Timon14kraan/Project-Proces-and-Safety/src/SUMMARY.md

# Summary

- [Structure](Structure.md)
- [Choices_description](./Choices_description.md)
- [Connections](./Connections.md)
- [Riskassesment](./Riskassessment.md)
- [Flowchart](./Flowchart.md)
- [Materials](./Materials.md)
- [Tasks](./Tasks.md)
