Timon14kraan/Project-Proces-and-Safety/External Documents/Solidworks/Bovenkant motor.JPG

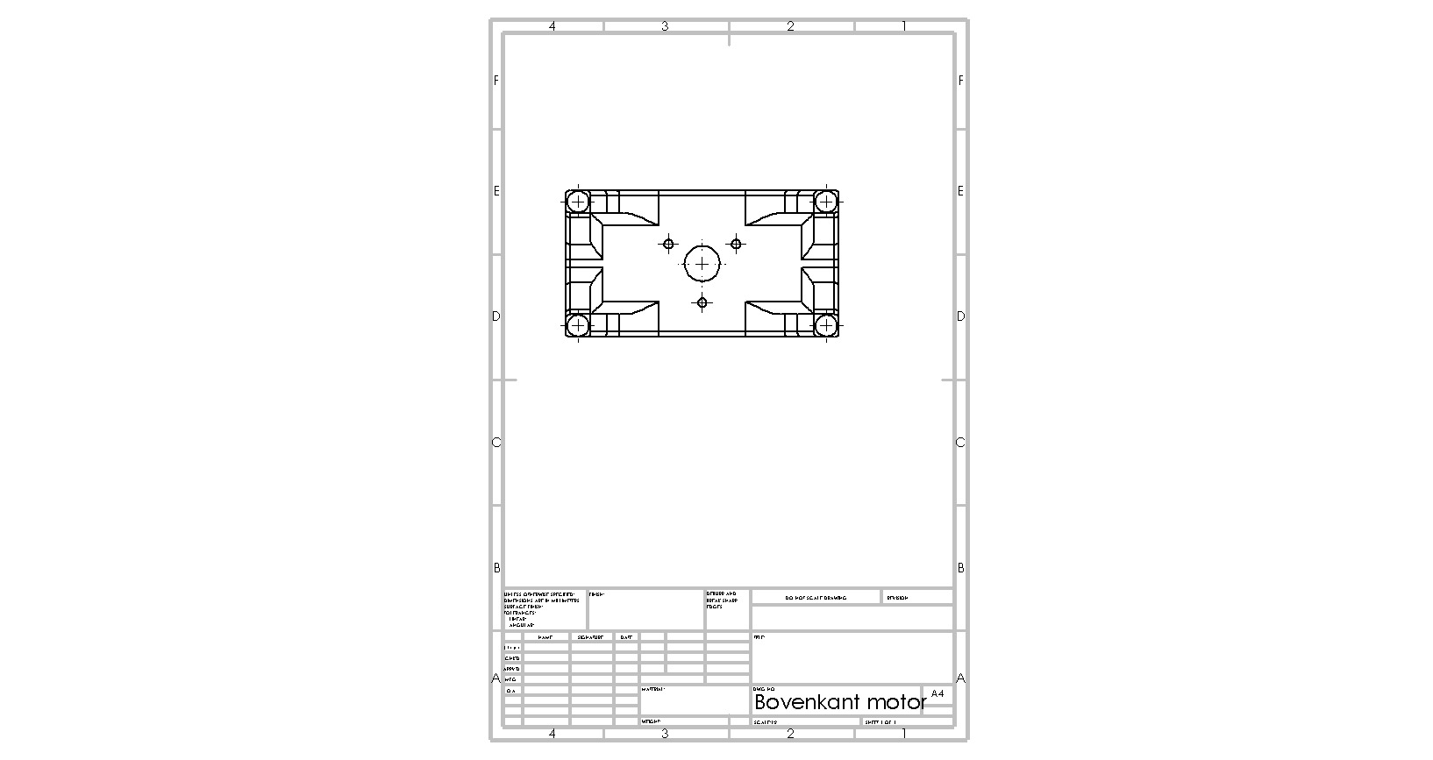
External Documents/Solidworks/Bovenkant motor.JPG
