Timon14kraan/Project-Proces-and-Safety/External Documents/Solidworks/motor_station_assembly.SLDASM

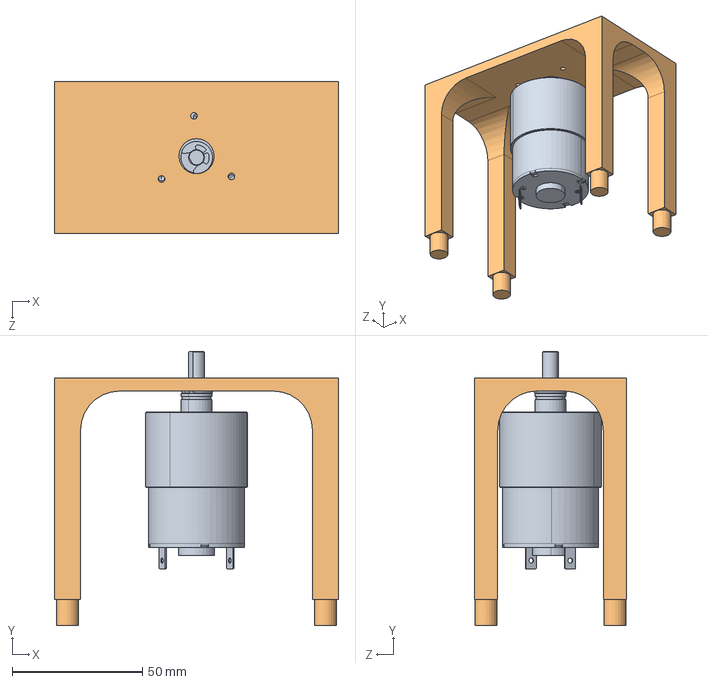
[picture p2: CAD file, 2024-01-18]
External Documents/Solidworks/motor_station_assembly.SLDASM
109.0 x 105.2 x 58.5 mm
Bovenkant motor
motor
