Timon14kraan/Project-Proces-and-Safety/External Documents/Solidworks/Gripper/MGP810N(01).sldasm

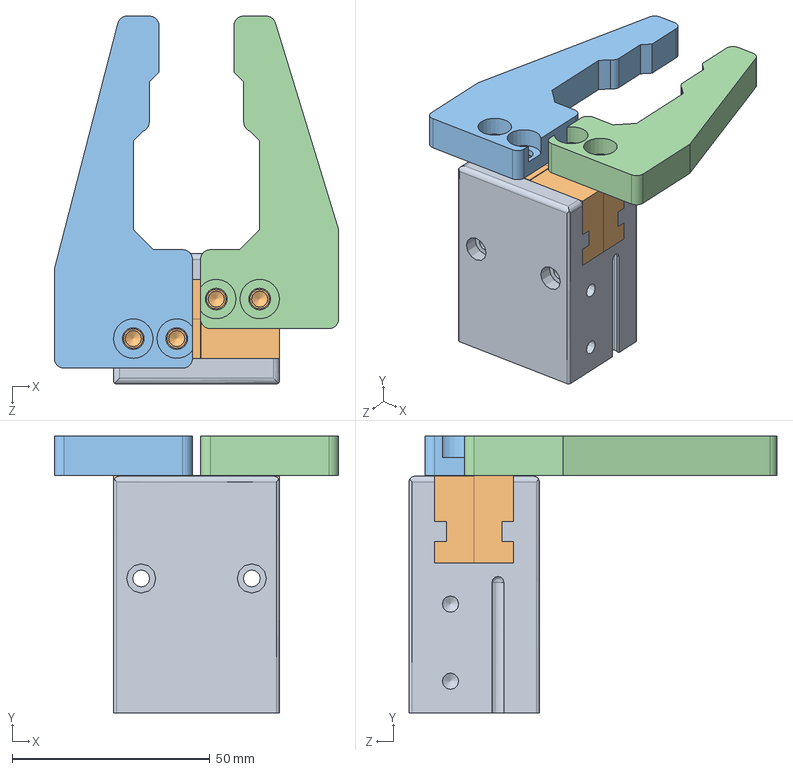
[picture p3: CAD file, 2024-01-18]
External Documents/Solidworks/Gripper/MGP810N(01).sldasm
72.0 x 70.0 x 93.1 mm
zylinder-MGP810N
bac-MGP810N1 x 2
gripper1_rev
gripper2_rev
