Timon14kraan/Project-Proces-and-Safety/External Documents/Solidworks/Bovenkant motor-DESKTOP-68PBQKE.SLDPRT

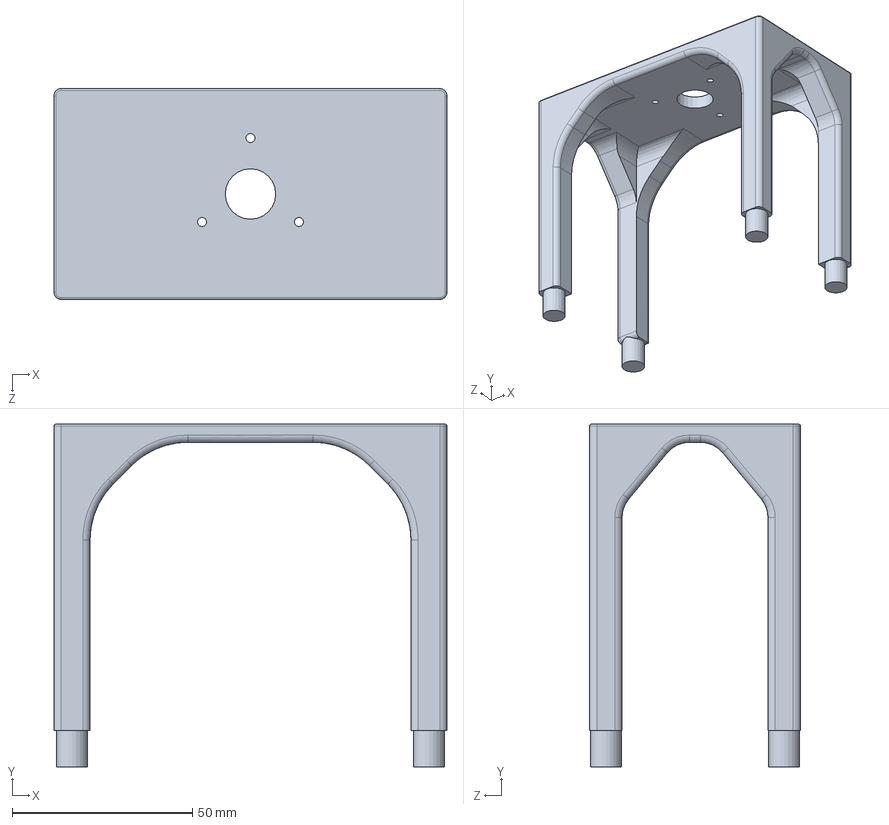
[picture p4: CAD file, 2024-01-18]
External Documents/Solidworks/Bovenkant motor-DESKTOP-68PBQKE.SLDPRT
109.0 x 95.0 x 58.5 mm
