Timon14kraan/Project-Proces-and-Safety/External Documents/Solidworks/Gripper/gripper2.SLDPRT

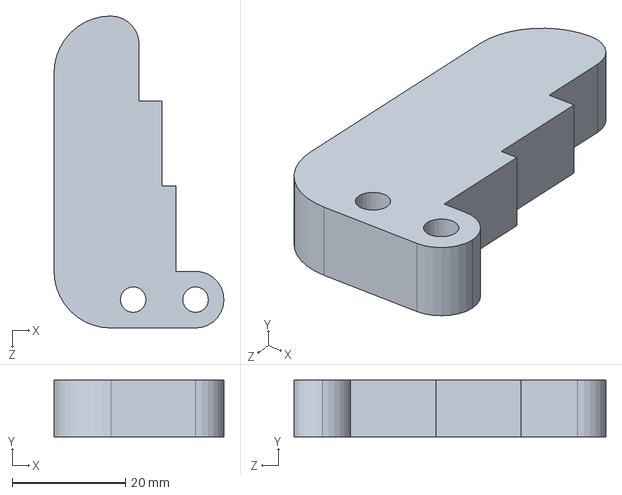
[picture p5: CAD file, 2024-01-18]
External Documents/Solidworks/Gripper/gripper2.SLDPRT
30.0 x 10.0 x 55.0 mm
