Timon14kraan/Project-Proces-and-Safety/External Documents/Solidworks/Motor-station/onderkant voor Motor.SLDPRT

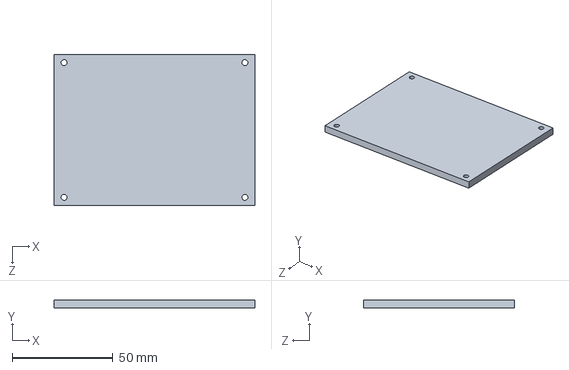
[picture p6: CAD file, 2024-01-18]
External Documents/Solidworks/Motor-station/onderkant voor Motor.SLDPRT
100.0 x 4.00 x 75.0 mm
