Timon14kraan/Project-Proces-and-Safety/External Documents/Solidworks/socket/cap.SLDPRT

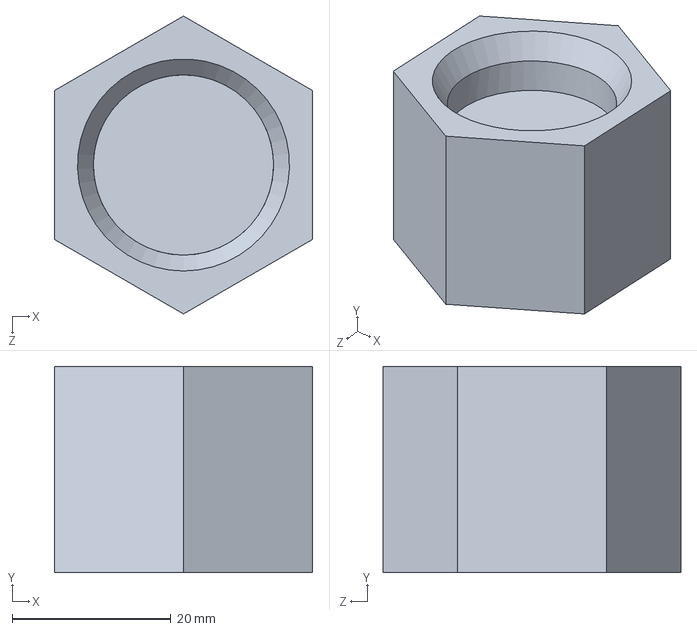
[picture p7: CAD file, 2024-01-18]
External Documents/Solidworks/socket/cap.SLDPRT
32.5 x 26.0 x 37.5 mm
