Timon14kraan/Project-Proces-and-Safety/External Documents/Solidworks/Gripper/gripper1_rev.SLDPRT

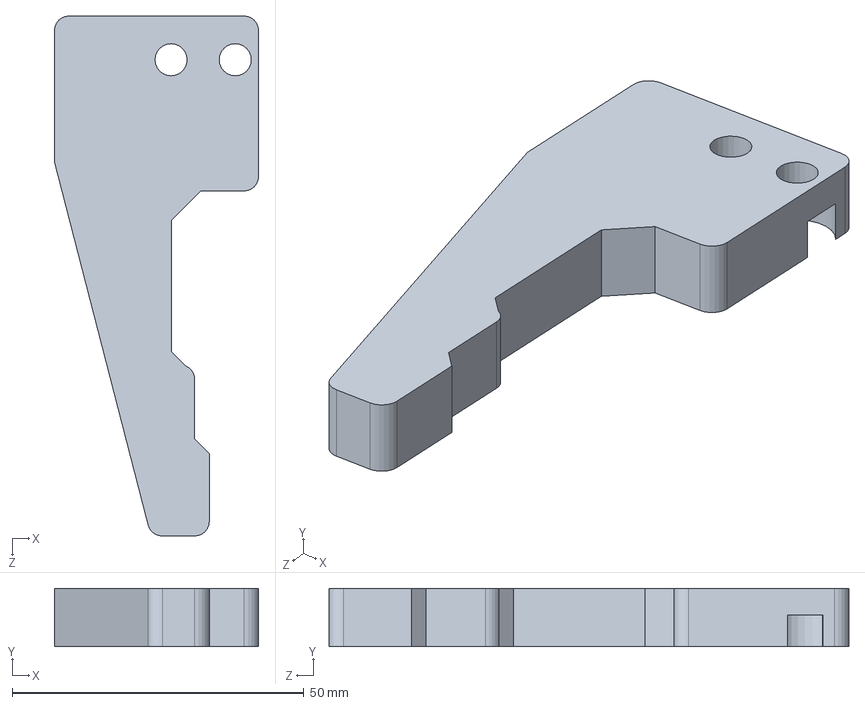
[picture p8: CAD file, 2024-01-18]
External Documents/Solidworks/Gripper/gripper1_rev.SLDPRT
35.0 x 10.0 x 89.1 mm
