Timon14kraan/Project-Proces-and-Safety/External Documents/Solidworks/Motor-station/motor.SLDPRT

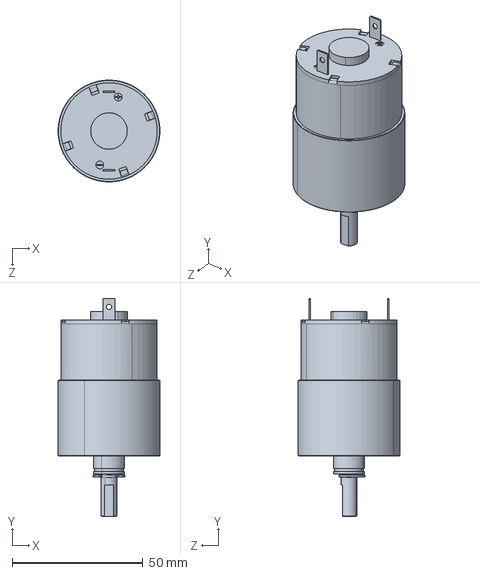
[picture p9: CAD file, 2024-01-18]
External Documents/Solidworks/Motor-station/motor.SLDPRT
39.0 x 83.4 x 39.0 mm
