Timon14kraan/Project-Proces-and-Safety/External Documents/Solidworks/socket/tube.SLDPRT

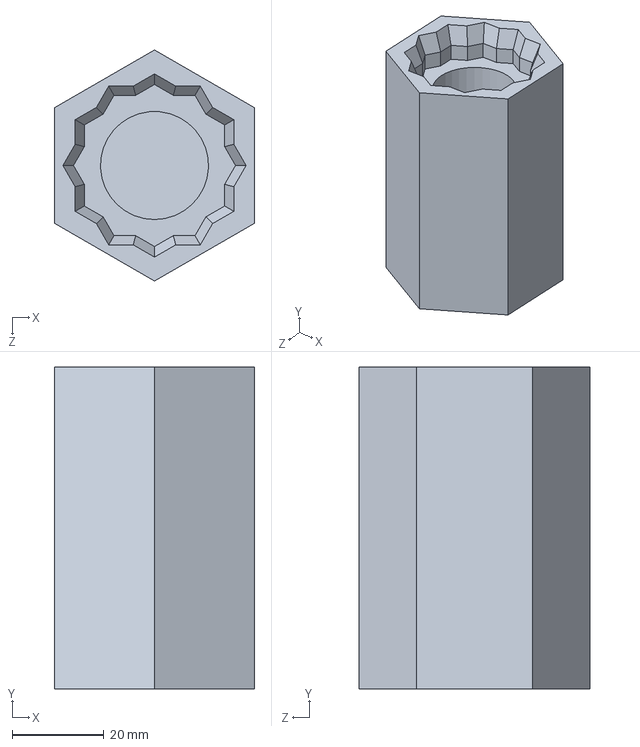
[picture p10: CAD file, 2024-01-18]
External Documents/Solidworks/socket/tube.SLDPRT
43.5 x 70.0 x 50.2 mm
