Timon14kraan/Project-Proces-and-Safety/External Documents/Solidworks/opslag_onderdelen.SLDPRT

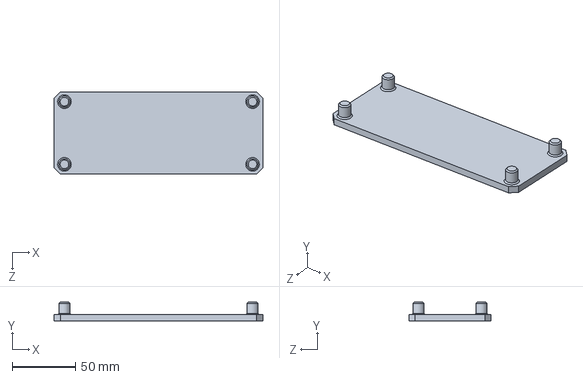
[picture p11: CAD file, 2024-01-18]
External Documents/Solidworks/opslag_onderdelen.SLDPRT
165.0 x 15.0 x 65.0 mm
