Timon14kraan/Project-Proces-and-Safety/External Documents/Solidworks/Bovenkant motor-DESKTOP-68PBQKE-2.SLDPRT

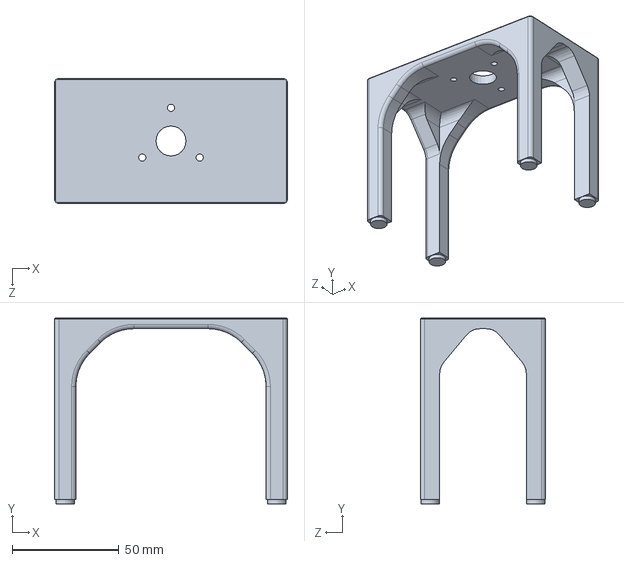
[picture p12: CAD file, 2024-01-18]
External Documents/Solidworks/Bovenkant motor-DESKTOP-68PBQKE-2.SLDPRT
109.0 x 87.0 x 58.5 mm
