Timon14kraan/Project-Proces-and-Safety/External Documents/Solidworks/Gripper/gripper1.SLDPRT

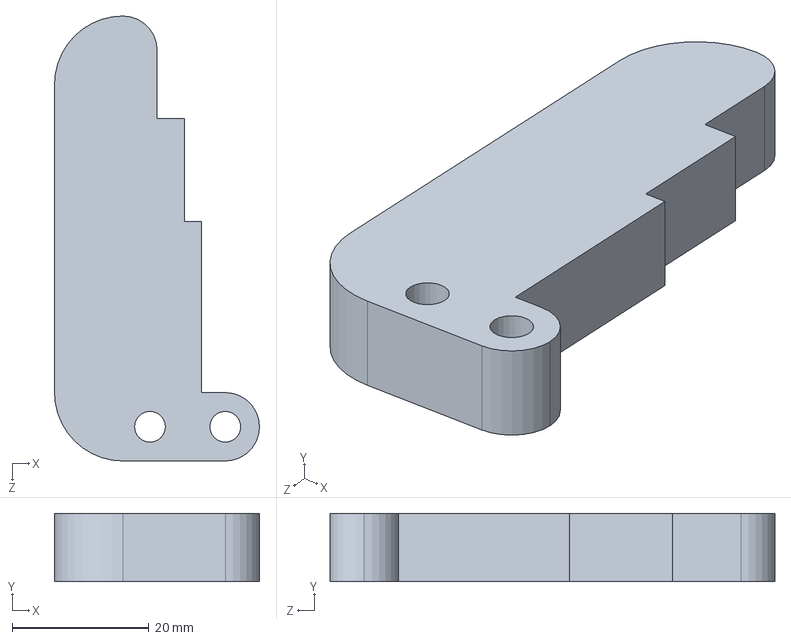
[picture p13: CAD file, 2024-01-18]
External Documents/Solidworks/Gripper/gripper1.SLDPRT
30.0 x 10.0 x 65.0 mm
