Timon14kraan/Project-Proces-and-Safety/External Documents/Solidworks/Gripper/gripper2_rev.SLDPRT

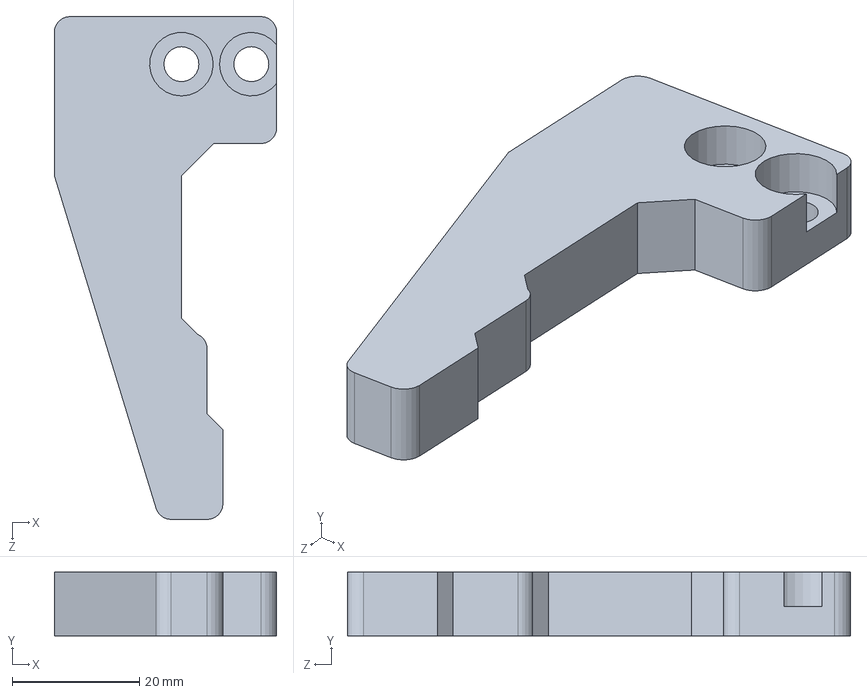
[picture p14: CAD file, 2024-01-18]
External Documents/Solidworks/Gripper/gripper2_rev.SLDPRT
35.0 x 10.0 x 79.1 mm
