Timon14kraan/Project-Proces-and-Safety/External Documents/Solidworks/Gripper/Part1.SLDPRT

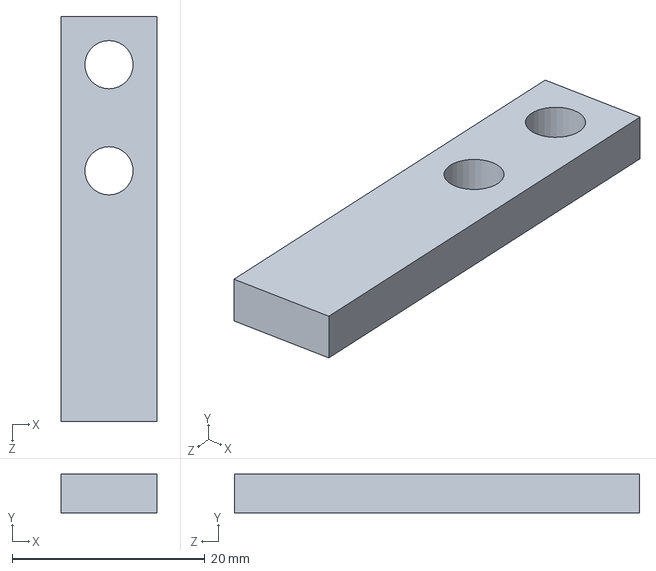
[picture p15: CAD file, 2024-01-18]
External Documents/Solidworks/Gripper/Part1.SLDPRT
10.0 x 4.00 x 42.0 mm
