Timon14kraan/Project-Proces-and-Safety/(list of files, cad)

Other CAD files:
External Documents/Solidworks/motor_station_assembly-DESKTOP-68PBQKE.SLDASM
External Documents/Solidworks/Motor-station/Bovenkant motor.SLDPRT
External Documents/Solidworks/Bovenkant motor.SLDPRT
External Documents/Solidworks/Gripper/bac-MGP810N1.sldprt
External Documents/Solidworks/motor.SLDPRT
External Documents/Solidworks/Bovenkant motor kleine voet.STL
External Documents/Solidworks/Gripper/zylinder-MGP810N.sldprt
External Documents/Solidworks/Bovenkant motor.SLDDRW
External Documents/Solidworks/Bovenkant motor.STL
External Documents/Solidworks/Gripper/gripper1_rev.STL
External Documents/Solidworks/Gripper/gripper2_rev.STL
External Documents/Solidworks/socket/bolt.SLDPRT
External Documents/Solidworks/socket/bolt.STL
External Documents/Solidworks/socket/cap.STL
External Documents/Solidworks/socket/tube.STL
