Timon14kraan/Project-Proces-and-Safety/(commit log)

2023-10-05 aanpassingen structure of the valve
2023-10-18 materials toegevoegd
2023-10-20 Materialen toegevoegd
2024-01-15 Aanpasingen flowchart
2024-01-18 Added external documents
    [Bovenkant motor kleine voet.STL, Bovenkant motor-DESKTOP-68PBQKE-2.SLDPRT, Bovenkant motor-DESKTOP-68PBQKE.SLDPRT, Bovenkant motor.SLDDRW, Bovenkant motor.SLDPRT, Bovenkant motor.STL, MGP810N(01).sldasm, Part1.SLDPRT]
